mitul93/Beaglebone-ECG/BBB-CAPE/BBB_Cape_schematics.brd

## EAGLE design BBB-CAPE/BBB_Cape_schematics.brd (2013-10-20)

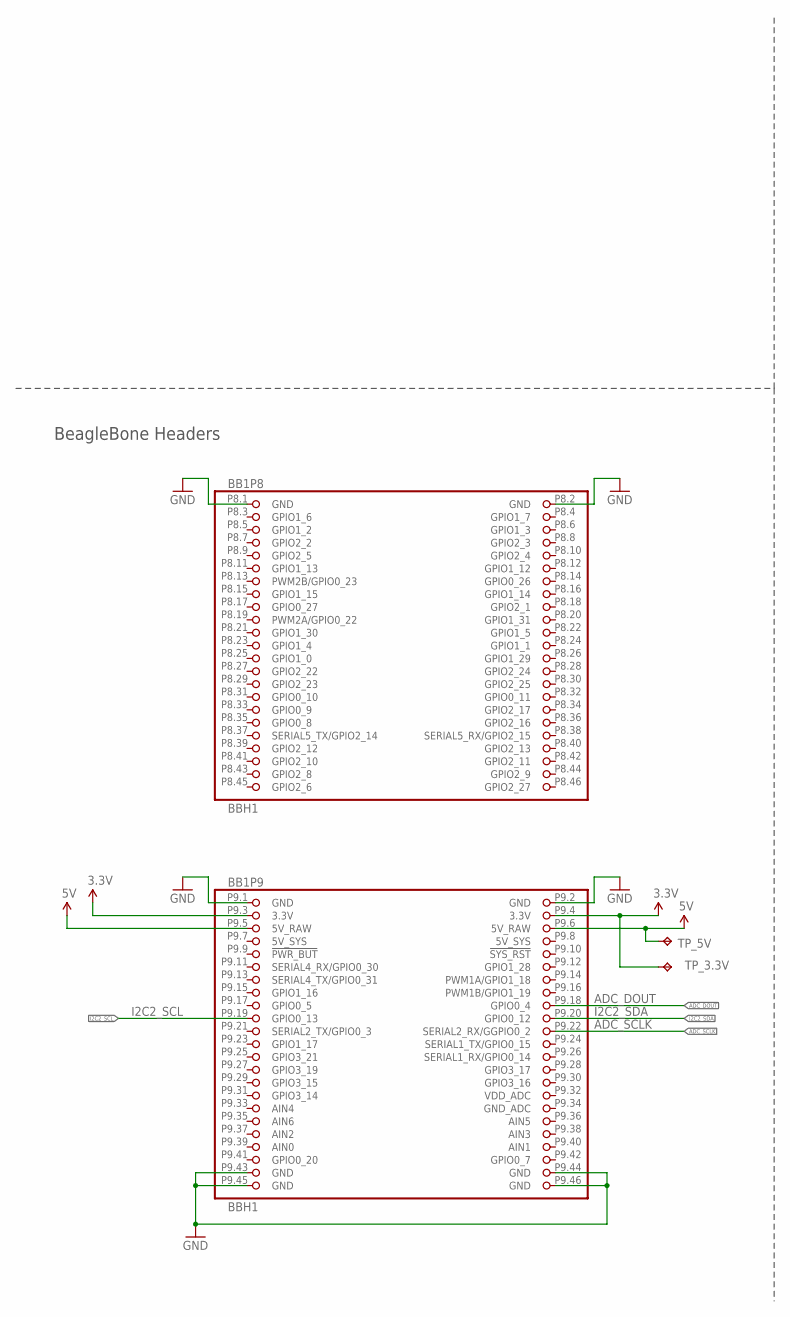
[picture p1: schematic BBB_Cape_schematics.sch, sheet 1, BB_Cape pinouts]

Parts:
BB1: BBH1; BB_CAPE
TP_3.3V, TP_5V: TPB2,54; B2,54

Connections:
3.3V: BB1.P9.3 (3.3V), BB1.P9.4 (3.3V), TP_3.3V.TP; also elsewhere on the board
5V: BB1.P9.5 (5V_RAW), BB1.P9.6 (5V_RAW), TP_5V.TP; also elsewhere on the board
5V_SYS: BB1.P9.7 (5V_SYS), BB1.P9.8 (5V_SYS)
ADC_DOUT: BB1.P9.18 (GPIO0_4); also elsewhere on the board
ADC_SCLK: BB1.P9.22 (SERIAL2_RX/GGPIO0_2); also elsewhere on the board
GND: BB1.P8.1 (GND), BB1.P8.2 (GND), BB1.P9.1 (GND), BB1.P9.2 (GND), BB1.P9.43 (GND), BB1.P9.44 (GND), BB1.P9.45 (GND), BB1.P9.46 (GND); also elsewhere on the board
I2C2_SCL: BB1.P9.19 (GPIO0_13)
I2C2_SDA: BB1.P9.20 (GPIO0_12)

Notes on the sheet:
BeagleBone Headers
ADC_SCLK
ADC_DOUT

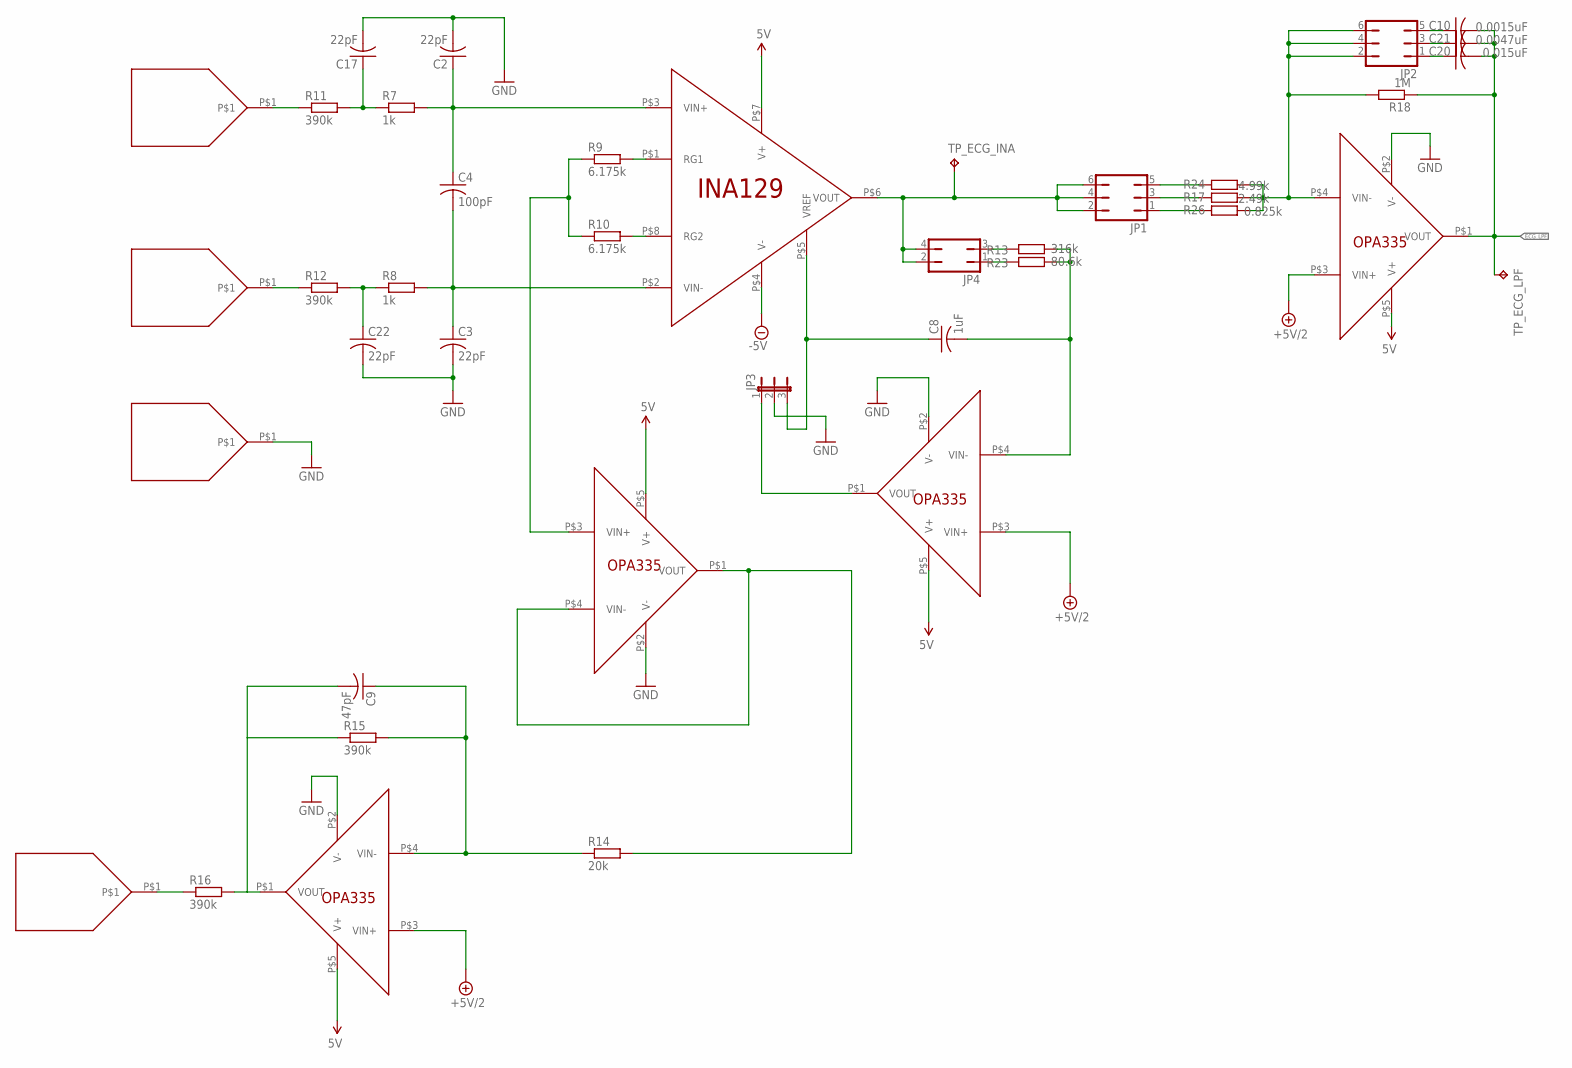
[picture p2: schematic BBB_Cape_schematics.sch, sheet 2, ECG_circuit]

Parts:
C2, C3, C17, C22: 22pF; C1206
C4: 100pF; C1206
C8: 1uF; C1206
C9: 47pF; C1206
C10: 0.0015uF; C1206
C20: 0.015uF; C1206
C21: 0.0047uF; C1206
JP1, JP2: JP3Q
JP3: JP2E; JP2
JP4: JP2Q
LH: PAD; RECT_PAD
LH_INDEX: PAD; RECT_PAD
R7, R8: 1k; M1206
R9, R10: 6.175k; M1206
R11, R12, R15, R16: 390k; M1206
R13: 316k; M1206
R14: 20k; M1206
R17: 2.49k; M1206
R18: 1M; M1206
R23: 80.6k; M1206
R24: 4.99k; M1206
R26: 0.825k; M1206
RH: PAD; RECT_PAD
RH_INDEX: PAD; RECT_PAD
TP_ECG_INA: TPB2,54; B2,54
TP_ECG_LPF: TPB2,54; B2,54
U4: INA129
U9, U11, U12, U13: OPA335; SOT23-5

Connections:
5V: U4.P$7 (V+), U9.P$5 (V+), U11.P$5 (V+), U12.P$5 (V+), U13.P$5 (V+); also elsewhere on the board
+5V/2: U9.P$3 (VIN+), U12.P$3 (VIN+), U13.P$3 (VIN+); also elsewhere on the board
-5V: U4.P$4 (V-); also elsewhere on the board
ECG_LPF: C10.2, C20.2, C21.2, R18.1, TP_ECG_LPF.TP, U13.P$1 (VOUT); also elsewhere on the board
GND: C2.2, C3.2, C17.2, C22.2, JP3.2, RH_INDEX.P$1, U9.P$2 (V-), U11.P$2 (V-), U12.P$2 (V-), U13.P$2 (V-); also elsewhere on the board
unnamed: C2.1, C4.1, R7.2, U4.P$3 (VIN+)
unnamed: C3.1, C4.2, R8.2, U4.P$2 (VIN-)
unnamed: R9.2, U4.P$1 (RG1)
unnamed: R10.2, U4.P$8 (RG2)
unnamed: R9.1, R10.1, U11.P$3 (VIN+)
unnamed: C17.1, R7.1, R11.2
unnamed: C22.1, R8.1, R12.2
unnamed: C8.1, JP3.3, U4.P$5 (VREF)
unnamed: JP1.2, JP1.4, JP1.6, JP4.2, JP4.4, TP_ECG_INA.TP, U4.P$6 (VOUT)
unnamed: C8.2, R13.2, R23.2, U9.P$4 (VIN-)
unnamed: R14.2, U11.P$1 (VOUT), U11.P$4 (VIN-)
unnamed: C9.1, R14.1, R15.2, U12.P$4 (VIN-)
unnamed: JP2.2, JP2.4, JP2.6, R17.1, R18.2, R24.1, R26.1, U13.P$4 (VIN-)
unnamed: C9.2, R15.1, R16.2, U12.P$1 (VOUT)
unnamed: LH_INDEX.P$1, R16.1
unnamed: R11.1, RH.P$1
unnamed: LH.P$1, R12.1
unnamed: JP4.3, R13.1
unnamed: JP4.1, R23.1
unnamed: JP3.1, U9.P$1 (VOUT)
unnamed: JP1.5, R24.2
unnamed: JP1.3, R17.2
unnamed: JP1.1, R26.2
unnamed: C10.1, JP2.5
unnamed: C21.1, JP2.3
unnamed: C20.1, JP2.1

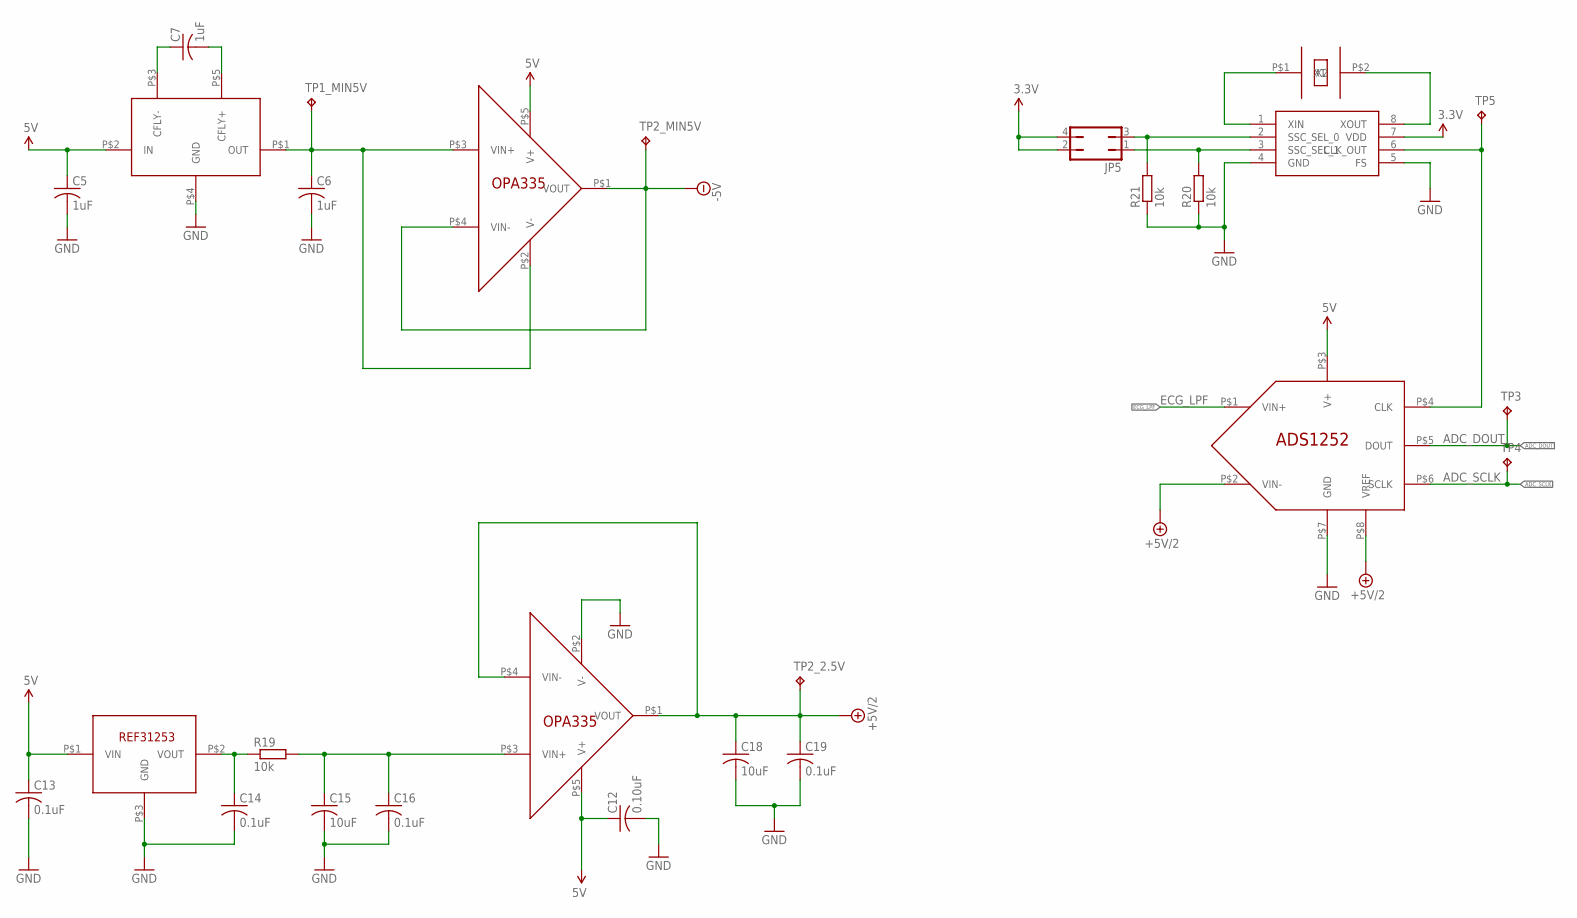
[picture p3: schematic BBB_Cape_schematics.sch, sheet 3, Power Supply]

Parts:
C5, C6, C7: 1uF; C1206
C12: 0.10uF; C1206
C13, C14, C16, C19: 0.1uF; C1206
C15, C18: 10uF; C1206
JP5: JP2Q
R19, R20, R21: 10k; M1206
TP1_MIN5V, TP2_2.5V, TP2_MIN5V, TP3, TP4, TP5: TPB2,54; B2,54
U5: TPS60403; SOT23-5
U10: CDCS502; SSOP-8
U14, U22: OPA335; SOT23-5
U19: ADS1252; SOIC-8
U21: REF3125; SOT23-3
U23: ATS16ASM-1; CRYSTAL_SMD

Connections:
3.3V: JP5.2, JP5.4, U10.7 (VDD); also elsewhere on the board
5V: C5.1, C12.1, C13.1, U5.P$2 (IN), U14.P$5 (V+), U19.P$3 (V+), U21.P$1 (VIN), U22.P$5 (V+); also elsewhere on the board
+5V/2: C18.1, C19.1, TP2_2.5V.TP, U19.P$2 (VIN-), U19.P$8 (VREF), U22.P$1 (VOUT), U22.P$4 (VIN-); also elsewhere on the board
-5V: TP2_MIN5V.TP, U14.P$1 (VOUT), U14.P$4 (VIN-); also elsewhere on the board
ADC_DOUT: TP3.TP, U19.P$5 (DOUT); also elsewhere on the board
ADC_SCLK: TP4.TP, U19.P$6 (SCLK); also elsewhere on the board
ECG_LPF: U19.P$1 (VIN+); also elsewhere on the board
GND: C5.2, C6.2, C12.2, C13.2, C14.2, C15.2, C16.2, C18.2, C19.2, R20.1, R21.1, U5.P$4 (GND), U10.4 (GND), U10.5 (FS), U19.P$7 (GND), U21.P$3 (GND), U22.P$2 (V-); also elsewhere on the board
unnamed: C7.2, U5.P$5 (CFLY+)
unnamed: C7.1, U5.P$3 (CFLY-)
unnamed: C6.1, TP1_MIN5V.TP, U5.P$1 (OUT), U14.P$2 (V-), U14.P$3 (VIN+)
unnamed: C14.1, R19.1, U21.P$2 (VOUT)
unnamed: C15.1, C16.1, R19.2, U22.P$3 (VIN+)
unnamed: U10.1 (XIN), U23.P$1 (X1)
unnamed: U10.8 (XOUT), U23.P$2 (X2)
unnamed: TP5.TP, U10.6 (CLK_OUT), U19.P$4 (CLK)
unnamed: JP5.3, R21.2, U10.2 (SSC_SEL_0)
unnamed: JP5.1, R20.2, U10.3 (SSC_SEL_1)

Notes on the sheet:
ECG_LPF
REF31253
ADC_SCLK
ADC_DOUT

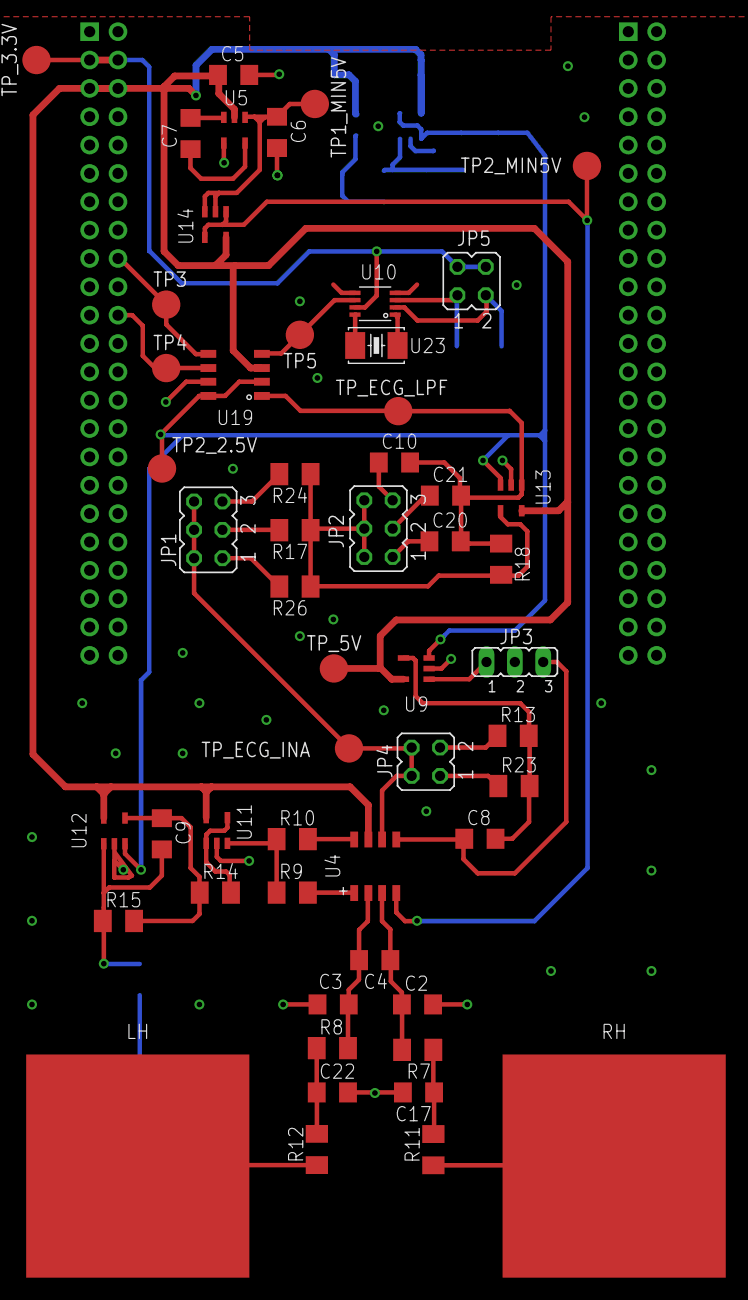
[picture p4: board BBB_Cape_schematics.brd from above]

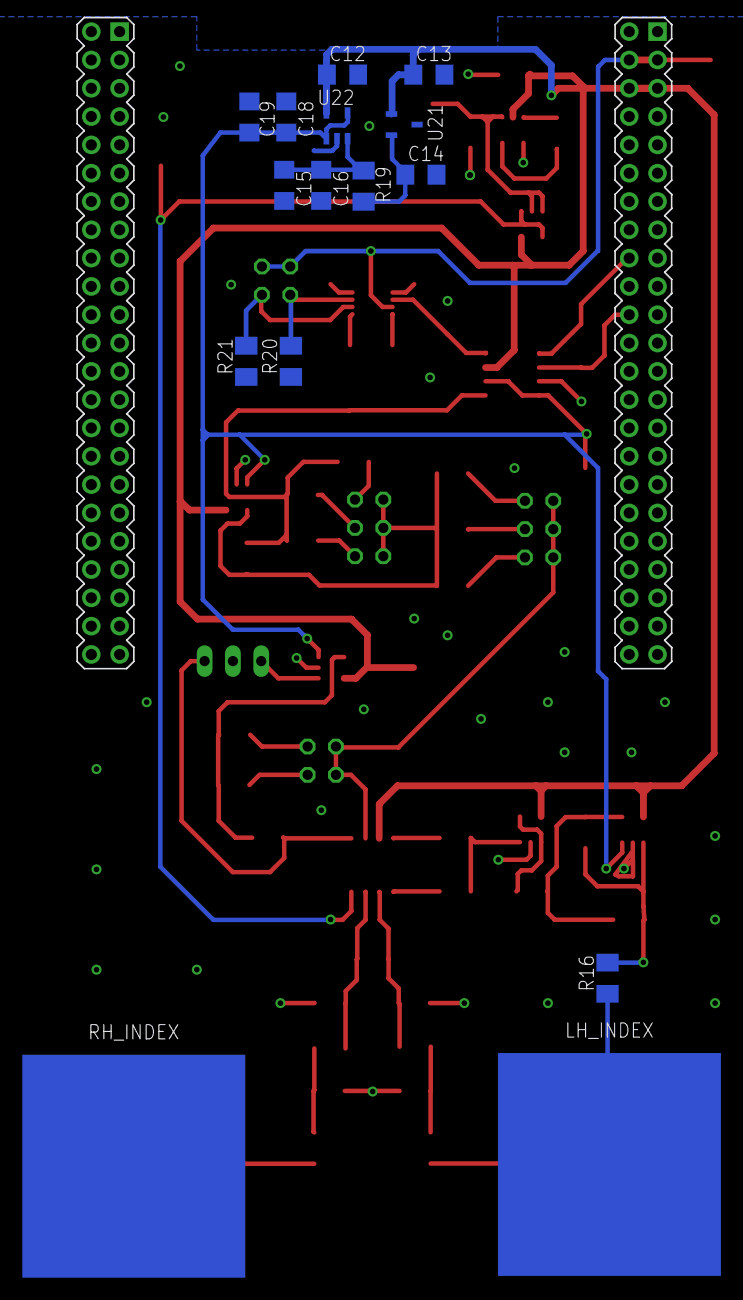
[picture p5: board BBB_Cape_schematics.brd from below]

Board: 2 copper layers, 70 parts (15 on the bottom side), 45 nets.
