mitul93/Beaglebone-ECG/(commit log)

2013-09-24 added TMS6040 to component library, changed outline of component symbol from tPlace to tDoc, added INA129, power supply and BB template to schematics
    [BB-cape.brd, BB-cape.sch, BBB_Cape_schematics.sch]
2013-09-25 Added RLD amp, +2.5V Ref and -5V generator circuit
    [BBB_Cape_schematics.sch]
2013-09-29 added device symbol and footprint for finger and thumb PAD
    [BBB_Cape_schematics.sch]
2013-09-29 added device symbol and footprint for ADS1252
2013-09-29 added symbol and footprint for OPA353
2013-09-29 removed REF5025 IC from schematic, instead using REF3125 to generate 2.5V reference voltage
    [BBB_Cape_schematics.sch]
2013-10-01 Add Clock ATS16ASM-1 to BBB_Cape_schematics.sch
    [BBB_Cape_schematics.sch]
2013-10-02 Add Resistors to INA129 HPF and LMP2021 LPF for selecting different cut-off frequency; Add DIP Switch in BBB_Cape_schematics.sch
    [BBB_Cape_schematics.sch]
2013-10-07 Add ground pad and remove Dip switch for power in BBB_Cape_schematics.sch
    [BBB_Cape_schematics.sch]
2013-10-09 Add ground pad(for index finger) in BBB_Cape_schematics.sch
    [BBB_Cape_schematics.sch]
2013-10-09 Change layout of Crystal oscillator and rename OPA353 to OPA335 in Components.lbr. Replace OPA2021 with OPA335 in LPF design in BBB_Cape_schematics.sch
    [BBB_Cape_schematics.sch]
2013-10-10 Add signal label and remove warnings by ERC (Electric Rule Check) in BBB_Cape_schematics.sch
    [BBB_Cape_schematics.sch]
2013-10-11 Create new layout file BBB_Cape_schematics.brd
    [BBB_Cape_schematics.brd]
2013-10-11 Placement of components in BBB_Cape_schematics.brd, removed ERC erros in BBB_Cape_schematics.sch and Add sign in INA129 to identify pin no 1 in Components.lbr
    [BBB_Cape_schematics.brd, BBB_Cape_schematics.sch]
2013-10-12 Revert "Create new layout file BBB_Cape_schematics.brd". Fresh start of layout.
    This reverts commit bc50a852f2955208c552cd840609eb4807d52a69.
    Conflicts:
    BBB-CAPE/BBB_Cape_schematics.brd
    [BBB_Cape_schematics.brd]
2013-10-12 Add 4D LCD component device symbol and footprint in Components.lbr
2013-10-12 Add 4D LCD to BBB_Cape_schematics.sch
    [BBB_Cape_schematics.sch]
2013-10-12 Replace all LMP2021 with OPA335 in BBB_Cape_schematics.sch
    [BBB_Cape_schematics.sch]
2013-10-13 Create new layout file and route -5V supply in BBB_Cape_schematics.brd
    [BBB_Cape_schematics.brd]
2013-10-13 Change +5V signal to 5V signal in BBB_Cape_schematics.sch and Update 12MHz crystal package in BBB_Cape_schematics.brd
    [BBB_Cape_schematics.brd, BBB_Cape_schematics.sch]
2013-10-13 Place components and Route for -5V, 2.5V supply in BBB_Cape_schematics.brd and Change +5V to 5V in BBB_schematics.sch
    [BBB_Cape_schematics.brd, BBB_Cape_schematics.sch]
2013-10-14 Solved error caused by imporper node connection across C4 and removed ERC errors in BBB_Cape_schematics.sch
    [BBB_Cape_schematics.sch]
2013-10-14 Connect N$1 with N$20 and N$2 with N$36 in BBB_Cape_schematics.sch
    [BBB_Cape_schematics.sch]
2013-10-14 Revert "Create new layout file BBB_Cape_schematics.brd"
    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
    [BBB_Cape_schematics.brd]
2013-10-14 Correct pin connection of U$13 Op-Amp in BBB_Cape_schematics.sch
    [BBB_Cape_schematics.sch]
2013-10-15 Add pin no 1 mark on SOIC-8 and SSOP-8 package in Components.lbr Replace Jumper by Solder jump in BBB_Cape_schematics.sch
    [BBB_Cape_schematics.sch]
2013-10-15 Remove one Resistor from LPF in in BBB_Cape_schematics.sch
    [BBB_Cape_schematics.sch]
2013-10-15 Create new layout file. Route -5V supply, 2.5V reference voltage, Finger and Thumb pads and INA in BBB_Cape_schematics.brd
    [BBB_Cape_schematics.brd]
2013-10-16 Route all components in PCB in BBB_Cape_schematics.brd
    [BBB_Cape_schematics.brd]
2013-10-16 Replace solder jump by 0.1 inch header to save space in board in BBB_Cape_schematics.sch
    [BBB_Cape_schematics.sch]
2013-10-19 Modify board boundary, Change orientation of Component names in Silk screen
    [BBB_Cape_schematics.brd, BBB_Cape_schematics.sch]
2013-10-20 Update Resistor and Capacitor value in BBB_Cape_schematics.sch
    [BBB_Cape_schematics.brd, BBB_Cape_schematics.sch]
